Sahal-Ansar/HexaPod/hxpod_temp.png

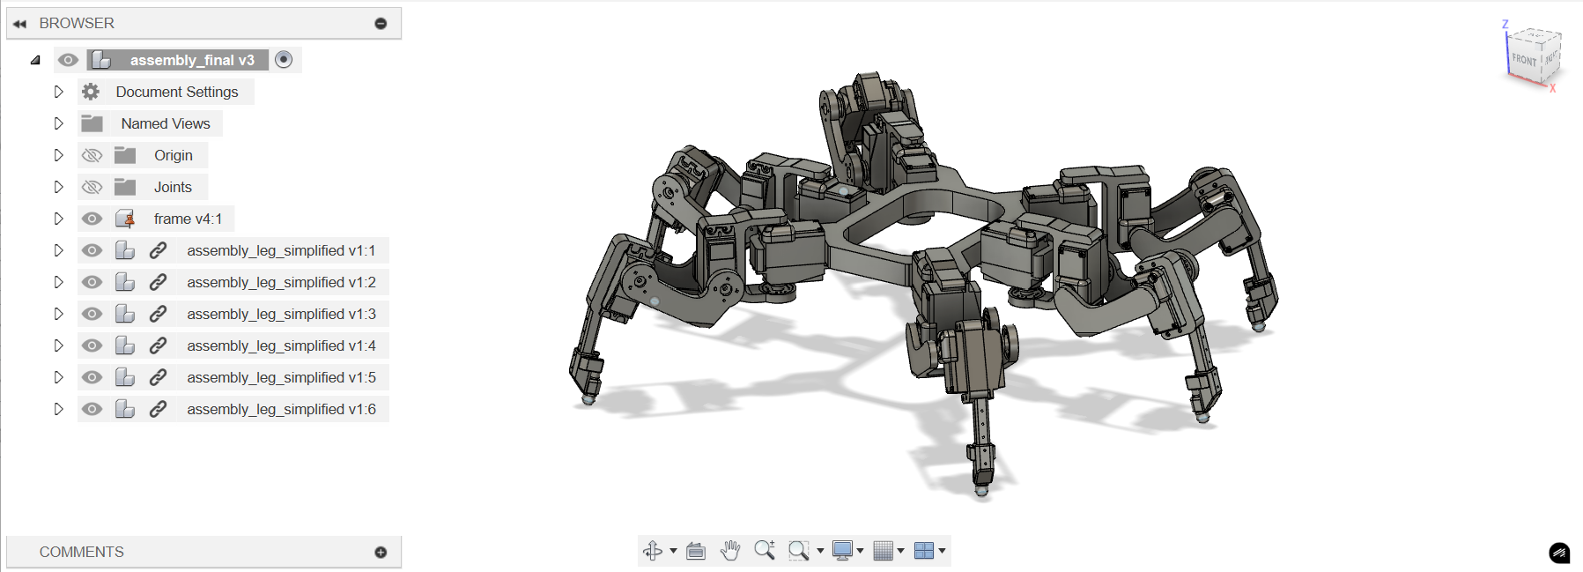
hxpod_temp.png
