Sahal-Ansar/HexaPod/(commit log)

2025-06-01 add leg forward, verification
2025-06-01 implement 3dof single leg IK
2025-06-07 add body kinematics for per-leg foot targeting
2025-06-07 pi-arduino serial protocol defined
2025-06-10 map joint anlges to pca channels with calib
2025-06-14 arduino setup with dual pca init
2025-06-15 add servo write helper, neutral startup pose
2025-06-18 parse servo command packets and drive all servos
2025-06-21 mpu imu reading added with complementary filter
2025-06-24 read debounced foot-contact limit switches
2025-07-06 added velocity and direction cmd interface
2025-07-10 uses IMU to keep body level via body kinematics
2025-07-16 added filtered ultrasonic obstacle detection
